Runcey/HOPE-Fa24-DawnWave/README.md

# HOPE-Fa24-DawnWave
## Install the [Espressif plugin](https://github.com/espressif/kicad-libraries) for KiCad!
