Runcey/HOPE-Fa24-DawnWave/HOPE-DawnWave-Core/HOPE-DawnWave-Core.pdf

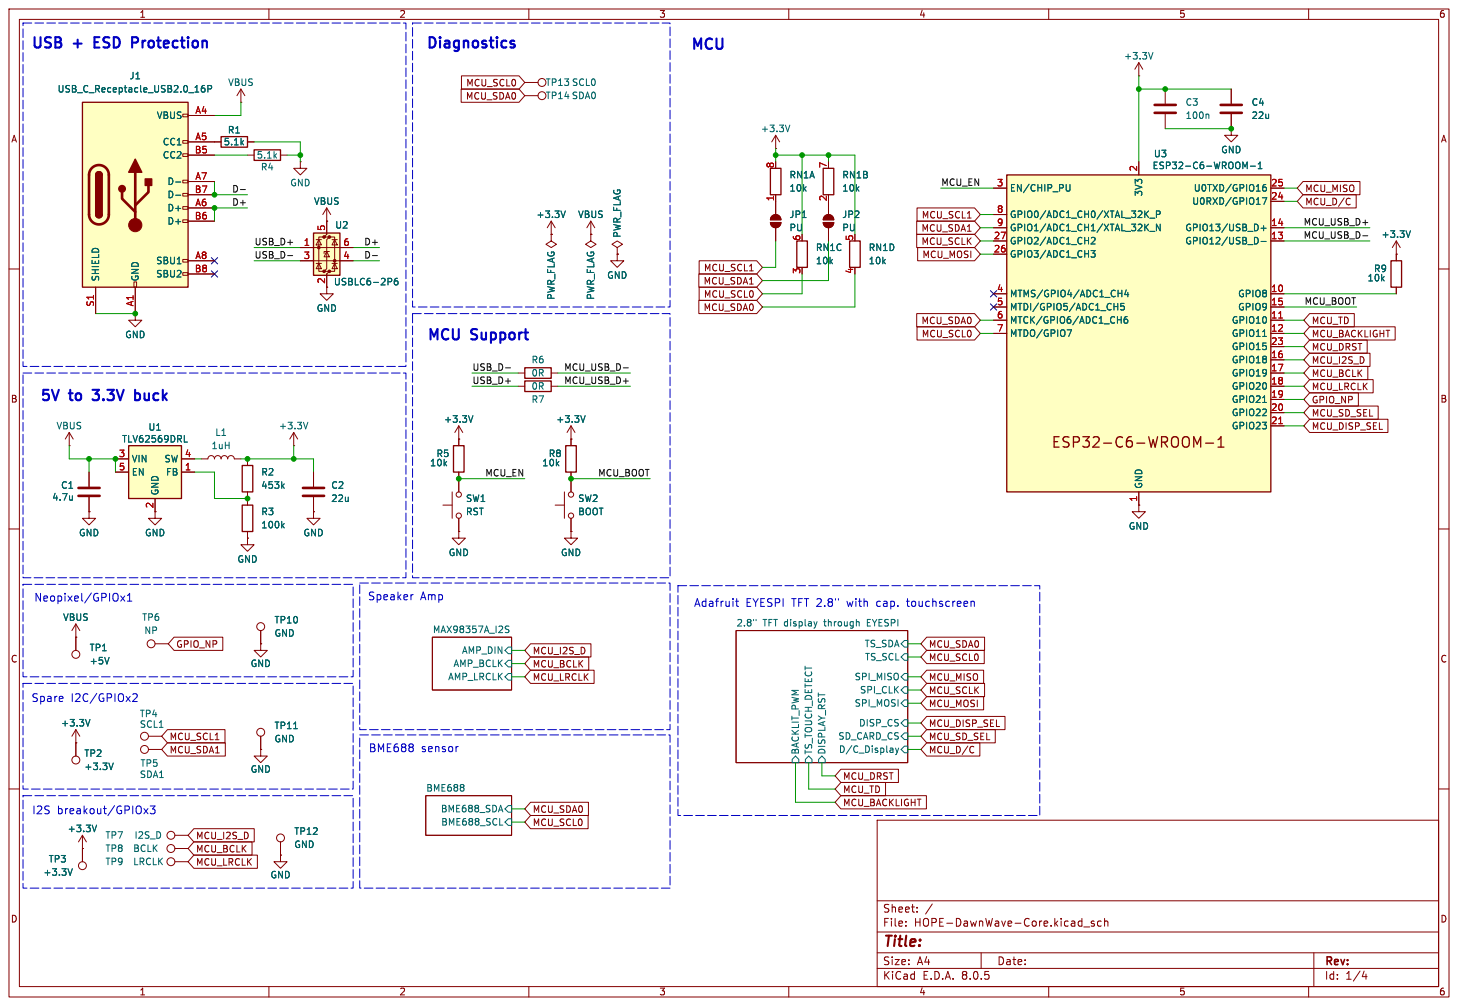
[picture p1: page 1]

2 GPIO22 20 GPIO23 21 GPIO15 23 U0RXD/GPIO17 24 U0TXD/GPIO16 25 GPIO3/ADC1_CH3 26 GPIO2/ADC1_CH2 27 EN/CHIP_PU 3 MTMS/GPIO4/ADC1_CH4 4 MTDI/GPIO5/ADC1_CH5 5 MTCK/GPIO6/ADC1_CH6 6 MTDO/GPIO7 7 GPIO0/ADC1_CH0/XTAL_32K_P 8 GPIO1/ADC1_CH1/XTAL_32K_N 9 U3 ESP32-C6-WROOM-1 R5

2 GPIO22 20 GPIO23 21 GPIO15 23 U0RXD/GPIO17 24 U0TXD/GPIO16 25 GPIO3/ADC1_CH3 26 GPIO2/ADC1_CH2 27 EN/CHIP_PU 3 MTMS/GPIO4/ADC1_CH4 4 MTDI/GPIO5/ADC1_CH5 5 MTCK/GPIO6/ADC1_CH6 6 MTDO/GPIO7 7 GPIO0/ADC1_CH0/XTAL_32K_P 8 GPIO1/ADC1_CH1/XTAL_32K_N 9 GND

2 VIN 3 SW 4 EN 5 U1 TLV62569DRL GND GND

2 VIN 3 SW 4 EN 5 GND

Id: 1/4 Title: File: HOPE-DawnWave-Core.kicad_sch Sheet: / BME688_SDA

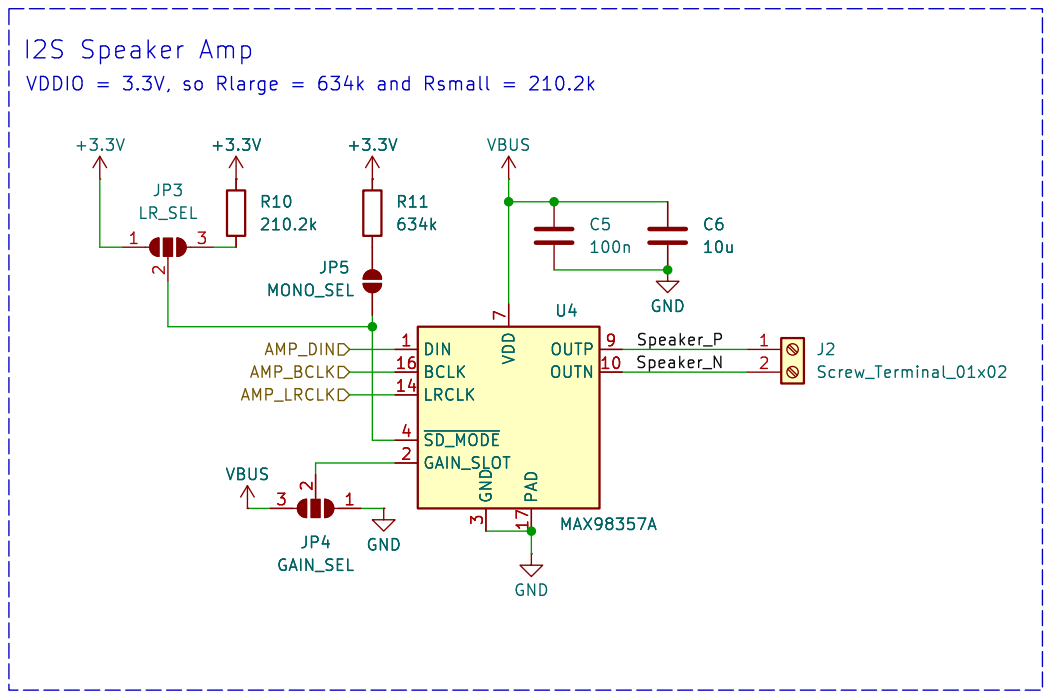
[picture p2: page 2]

Id: 2/4 Title: File: HOPE-DawnWave-Speaker-Amp.kicad_sch Sheet: /MAX98357A_I2S/

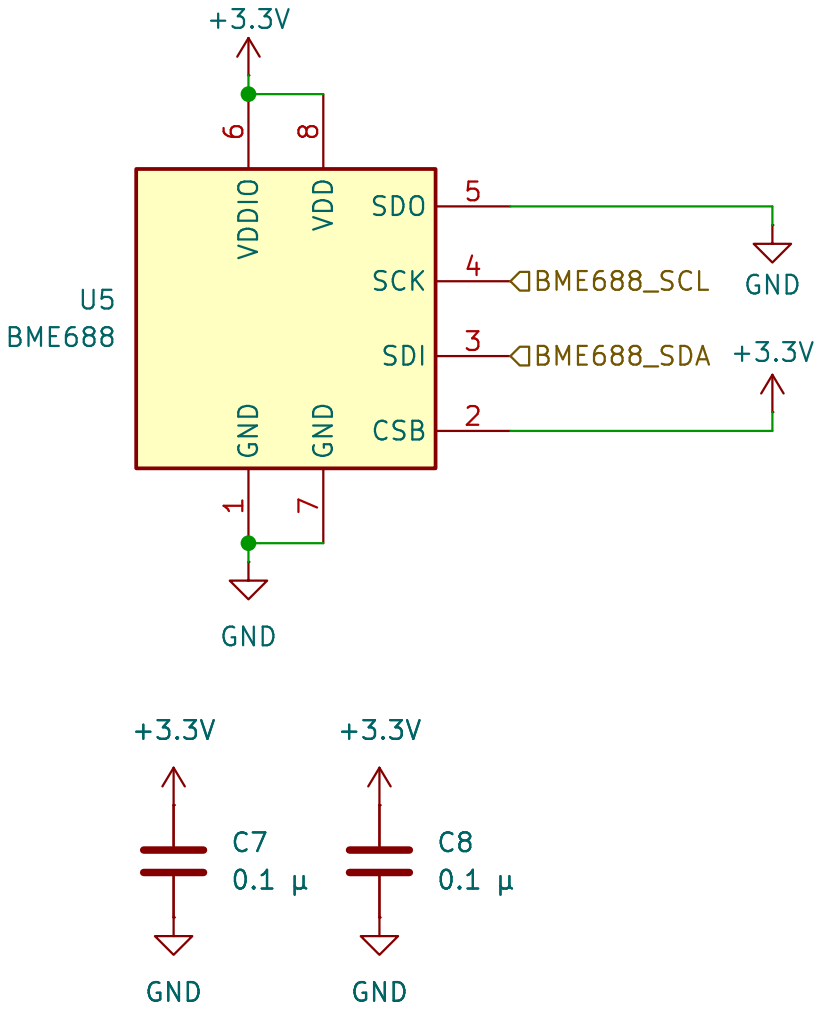
[picture p3: page 3]

1 CSB 2 SDI 3 SCK 4 SDO 5 VDDIO

Id: 3/4 Title: File: HOPE-DawnWave-BME688.kicad_sch Sheet: /BME688/ GND

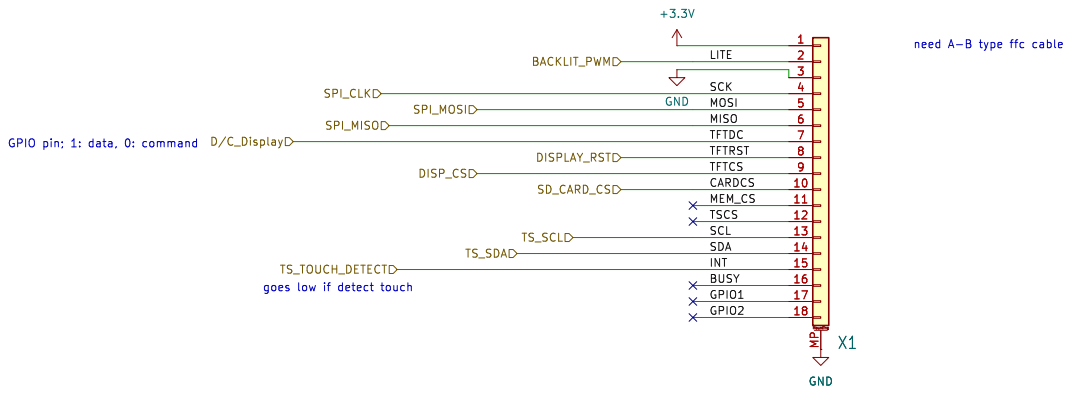
[picture p4: page 4]

LITE GPIO2 MOSI TFTCS MISO GPIO pin; 1: data, 0: command

goes low if detect touch
