Runcey/HOPE-Fa24-DawnWave/HOPE-DawnWave-Core/HOPE-DawnWave-Core.kicad_pcb

## KiCad design HOPE-DawnWave-Core/HOPE-DawnWave-Core.kicad_pcb (2024-11-07)

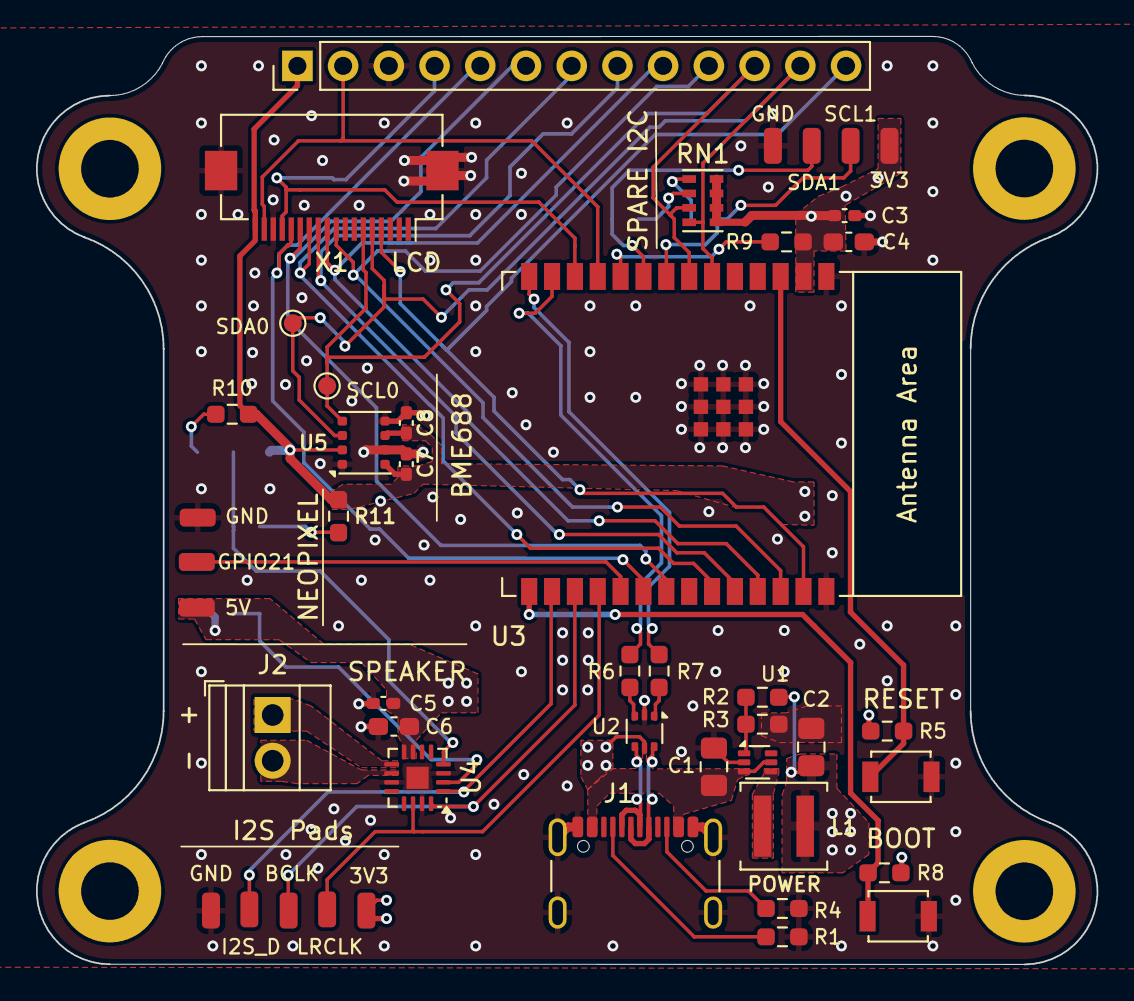
[picture p5: board HOPE-DawnWave-Core.kicad_pcb from above]

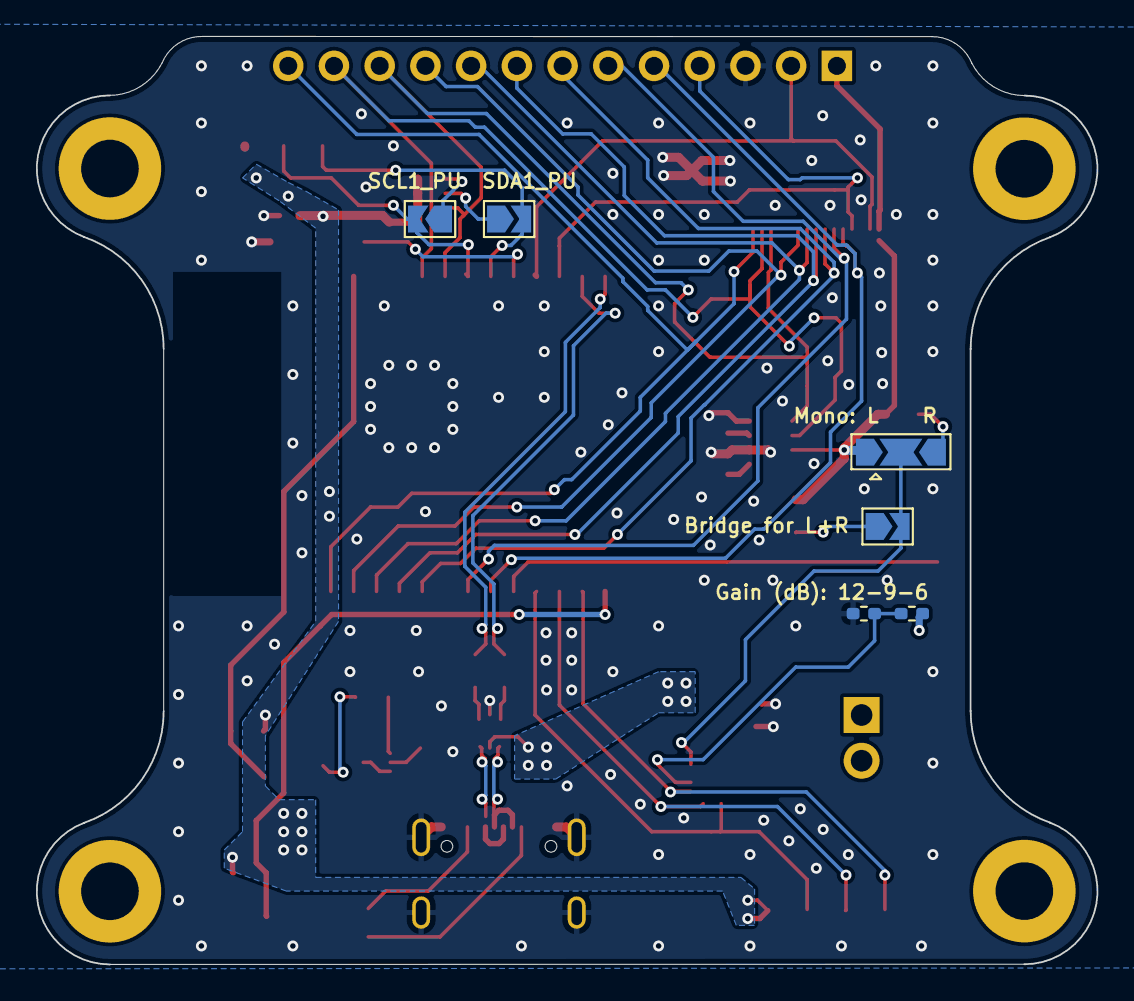
[picture p6: board HOPE-DawnWave-Core.kicad_pcb from below]

Board: 2 copper layers, 58.9 x 51.6 mm, 56 parts (6 on the bottom side), 41 nets.

Parts:
C1: 4.7u; C_0805_2012Metric_Pad1.18x1.45mm_HandSolder
C2: 22u; C_0805_2012Metric_Pad1.18x1.45mm_HandSolder
C3, C5: 100n; C_0402_1005Metric_Pad0.74x0.62mm_HandSolder
C4: 22u; C_0603_1608Metric_Pad1.08x0.95mm_HandSolder
C6: 10u; C_0603_1608Metric_Pad1.08x0.95mm_HandSolder
C7, C8: 0.1 µ; C_0402_1005Metric_Pad0.74x0.62mm_HandSolder
H1, H2, H3, H4: MountingHole; MountingHole_3.2mm_M3_ISO7380_Pad
J1: USB_C_Receptacle_USB2.0_16P; USB_C_Receptacle_GCT_USB4105-xx-A_16P_TopMnt_Horizontal
J2: Screw_Terminal_01x02; TerminalBlock_Xinya_XY308-2.54-2P_1x02_P2.54mm_Horizontal
J3: Conn_01x13_Pin; PinHeader_1x13_P2.54mm_Vertical
JP1, JP2: PU; SolderJumper-2_P1.3mm_Open_TrianglePad1.0x1.5mm
JP3: LR_SEL; SolderJumper-3_P2.0mm_Open_TrianglePad1.0x1.5mm
JP5: MONO_SEL; SolderJumper-2_P1.3mm_Open_TrianglePad1.0x1.5mm
L1: 1uH; L_Coilcraft_XAL4020-XXX
R1, R4: 5.1k; R_0603_1608Metric_Pad0.98x0.95mm_HandSolder
R2: 453k; R_0603_1608Metric_Pad0.98x0.95mm_HandSolder
R3: 100k; R_0603_1608Metric_Pad0.98x0.95mm_HandSolder
R5, R8, R9: 10k; R_0603_1608Metric_Pad0.98x0.95mm_HandSolder
R6, R7: 0R; R_0603_1608Metric_Pad0.98x0.95mm_HandSolder
R10: 210.2k; R_0603_1608Metric_Pad0.98x0.95mm_HandSolder
R11: 634k; R_0603_1608Metric_Pad0.98x0.95mm_HandSolder
R12, R13: 0R; R_0402_1005Metric_Pad0.72x0.64mm_HandSolder
RN1: 10k; R_Cat16-4
SW1: RST; SW_SPST_B3U-1000P
SW2: BOOT; SW_SPST_B3U-1000P
TP1: +5V; SolderWirePad_1x01_SMD_1x2mm
TP2, TP3: +3.3V; SolderWirePad_1x01_SMD_1x2mm
TP4: SCL1; SolderWirePad_1x01_SMD_1x2mm
TP5: SDA1; SolderWirePad_1x01_SMD_1x2mm
TP6: NP; SolderWirePad_1x01_SMD_1x2mm
TP7: I2S_D; SolderWirePad_1x01_SMD_1x2mm
TP8: BCLK; SolderWirePad_1x01_SMD_1x2mm
TP9: LRCLK; SolderWirePad_1x01_SMD_1x2mm
TP10, TP11, TP12: GND; SolderWirePad_1x01_SMD_1x2mm
TP13: SCL0; TestPoint_Pad_D1.0mm
TP14: SDA0; TestPoint_Pad_D1.0mm
U1: TLV62569DRL; SOT-563
U2: USBLC6-2P6; SOT-666
U3: ESP32-C6-WROOM-1
U4: MAX98357A; TQFN-16-1EP_3x3mm_P0.5mm_EP1.23x1.23mm
U5: BME688; Bosch_LGA-8_3x3mm_P0.8mm_ClockwisePinNumbering
X1: EYE_SPI_DISPLAY_FLIP; Hirose_FH12-18S-0.5SH_1x18-1MP_P0.50mm_Horizontal

Connections:
+3.3V: C2.1, C3.1, C4.1, C7.1, C8.1, J3.1, JP3.1 (A), L1.2, R2.1, R5.1, R8.1, R9.1, R10.2, R11.1, RN1.5 (R4.2), RN1.6 (R3.2), RN1.7 (R2.2), RN1.8 (R1.2), TP2.1, TP3.1, U3.2 (3V3), U5.2 (CSB), U5.6 (VDDIO), U5.8 (VDD), X1.18
/D+: J1.A6 (D+), J1.B6 (D+), U2.6 (I/O1)
/D-: J1.A7 (D-), J1.B7 (D-), U2.4 (I/O2)
/MAX98357A_I2S/Speaker_N: J2.2, U4.10 (OUTN)
/MAX98357A_I2S/Speaker_P: J2.1, U4.9 (OUTP)
/MCU_BOOT: R8.2, SW2.2, U3.15 (GPIO9)
/MCU_EN: R5.2, SW1.2, U3.3 (EN/CHIP_PU)
/MCU_USB_D+: R7.2, U3.14 (GPIO13/USB_D+)
/MCU_USB_D-: R6.2, U3.13 (GPIO12/USB_D-)
/USB_D+: R7.1, U2.1 (I/O1)
/USB_D-: R6.1, U2.3 (I/O2)
GND: C1.1, C2.2, C3.2, C4.2, C5.2, C6.2, C7.2, C8.2, J1.A1 (GND), J1.A12 (GND), J1.B1 (GND), J1.B12 (GND), J1.S1 (SHIELD), J3.3, R1.2, R3.2, R4.2, R13.2, SW1.1, SW2.1, TP10.1, TP11.1, TP12.1, U1.2 (GND), U2.2 (GND), U3.1 (GND), U3.28 (GND), U3.29 (GND), U4.3 (GND), U4.11 (GND), U4.15 (GND), U4.17 (PAD), U5.1 (GND), U5.5 (SDO), U5.7 (GND), X1.16, X1.MP (MountPin)
GPIO_NP: TP6.1, U3.19 (GPIO21)
MCU_BACKLIGHT: J3.2, U3.11 (GPIO10), X1.17
MCU_BCLK: TP8.1, U3.17 (GPIO19), U4.16 (BCLK)
MCU_DISP_SEL: J3.9, U3.25 (U0TXD/GPIO16), X1.10
MCU_DRST: J3.8, U3.24 (U0RXD/GPIO17), X1.11
MCU_D/C: J3.7, U3.23 (GPIO15), X1.12
MCU_I2S_D: TP7.1, U3.16 (GPIO18), U4.1 (DIN)
MCU_LRCLK: TP9.1, U3.18 (GPIO20), U4.14 (LRCLK)
MCU_MISO: J3.6, U3.21 (GPIO23), X1.13
MCU_MOSI: J3.5, U3.20 (GPIO22), X1.14
MCU_SCL0: J3.11, RN1.3 (R3.1), TP13.1, U3.7 (MTDO/GPIO7), U5.4 (SCK), X1.6
MCU_SCL1: JP1.2 (B), TP4.1, U3.8 (GPIO0/ADC1_CH0/XTAL_32K_P)
MCU_SCLK: J3.4, U3.12 (GPIO11), X1.15
MCU_SDA0: J3.12, RN1.4 (R4.1), TP14.1, U3.6 (MTCK/GPIO6/ADC1_CH6), U5.3 (SDI), X1.5
MCU_SDA1: JP2.2 (B), TP5.1, U3.9 (GPIO1/ADC1_CH1/XTAL_32K_N)
MCU_SD_SEL: J3.10, U3.26 (GPIO3/ADC1_CH3), X1.9
MCU_TD: J3.13, U3.27 (GPIO2/ADC1_CH2), X1.4
unnamed: J1.A5 (CC1), R1.1
unnamed: J1.B5 (CC2), R4.1
unnamed: JP1.1 (A), RN1.1 (R1.1)
unnamed: JP2.1 (A), RN1.2 (R2.1)
unnamed: JP3.3 (B), R10.1
unnamed: JP3.2 (C), JP5.2 (B), U4.4 (~SD_MODE)
unnamed: JP5.1 (A), R11.2
unnamed: R2.2, R3.1, U1.1 (FB)
unnamed: L1.1, U1.4 (SW)
unnamed: R9.2, U3.10 (GPIO8)
unnamed: R12.2, R13.1, U4.2 (GAIN_SLOT)
VBUS: C1.2, C5.1, C6.1, J1.A4 (VBUS), J1.A9 (VBUS), J1.B4 (VBUS), J1.B9 (VBUS), R12.1, TP1.1, U1.3 (VIN), U1.5 (EN), U2.5 (VBUS), U4.7 (VDD), U4.8 (VDD)
