Runcey/HOPE-Fa24-DawnWave/(commit log)

2024-10-26 initial push for work woa
    [HOPE-DawnWave-BME688.kicad_pcb, HOPE-DawnWave-BME688.kicad_sch, HOPE-DawnWave-Core.kicad_pcb, HOPE-DawnWave-Core.kicad_sch, HOPE-DawnWave-EyeSPI-Breakout.kicad_pcb, HOPE-DawnWave-EyeSPI-Breakout.kicad_sch, HOPE-DawnWave-Speaker-Amp.kicad_pcb, HOPE-DawnWave-Speaker-Amp.kicad_sch]
2024-10-26 removed extra file
    [untitled.kicad_sch]
2024-10-28 positions of some components - buck converter and usb c - completed
    [HOPE-DawnWave-Core.kicad_pcb, HOPE-DawnWave-Core.kicad_sch]
2024-10-28 Moved components to rough areas, not start on connecting
    [HOPE-DawnWave-Core.kicad_pcb]
2024-10-28 flipped esp32 to keep 3.3v on right and 5v on left
    [HOPE-DawnWave-Core.kicad_pcb, HOPE-DawnWave-Core.kicad_sch]
2024-10-29 fixed gitignore and completed major component placement iteration
    [HOPE-DawnWave-Core.kicad_pcb, HOPE-DawnWave-Core.kicad_sch]
2024-10-29 big progress oops
    [HOPE-DawnWave-Core.kicad_pcb, HOPE-DawnWave-Core.kicad_sch]
2024-10-29 Initial layout, need to resolve errors
    [HOPE-DawnWave-Core.kicad_pcb, HOPE-DawnWave-Core.kicad_sch]
2024-10-30 fixed 2 fixable drc errors - thermal reliefs
    [HOPE-DawnWave-Core.kicad_pcb]
2024-10-30 moved vias to fix via in pad stuff
    [HOPE-DawnWave-Core.kicad_pcb]
2024-10-31 fixed spacing on high speed lines, added ground via stitching, made power polygons a bit cleaner, silkscreen labeling is still not done but all warnings are gone
    [HOPE-DawnWave-Core.kicad_pcb, HOPE-DawnWave-Core.kicad_sch]
2024-11-06 corrected eyespi connector wiring and added a 2.54mm pitch header to break it out in case something bad happens
    [HOPE-DawnWave-Core.kicad_pcb, HOPE-DawnWave-Core.kicad_sch, HOPE-DawnWave-EyeSPI-Breakout.kicad_sch]
2024-11-06 a bit better
    [HOPE-DawnWave-Core.kicad_pcb]
2024-11-06 functional silkscreen complete
    [HOPE-DawnWave-Core.kicad_pcb]
2024-11-07 fab files generated, pcb finalized
    [HOPE-DawnWave-Core.kicad_pcb, HOPE-DawnWave-Core.kicad_sch, HOPE-DawnWave-Speaker-Amp.kicad_sch]
2024-11-07 whoa thats a lot of manufacturing files
    [HOPE-DawnWave-Core.kicad_pcb]
